Jelte-Boumans/balancerende-robot/GIP Presentatie.pptx

## Balancerende Robot

Jelte Boumans
6EA-ICT
1

## Blokschema

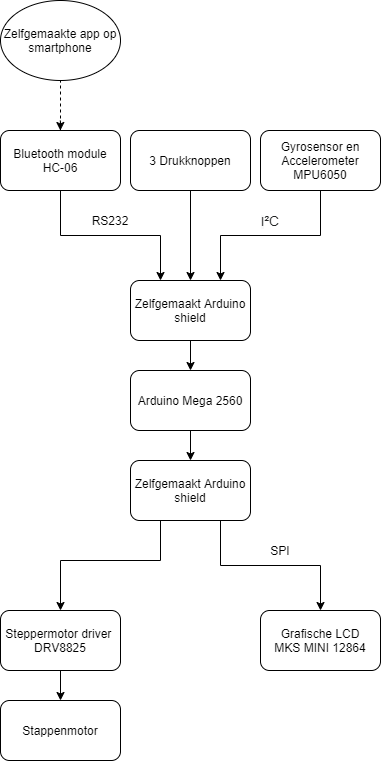
[picture p36: figure]

## Schema

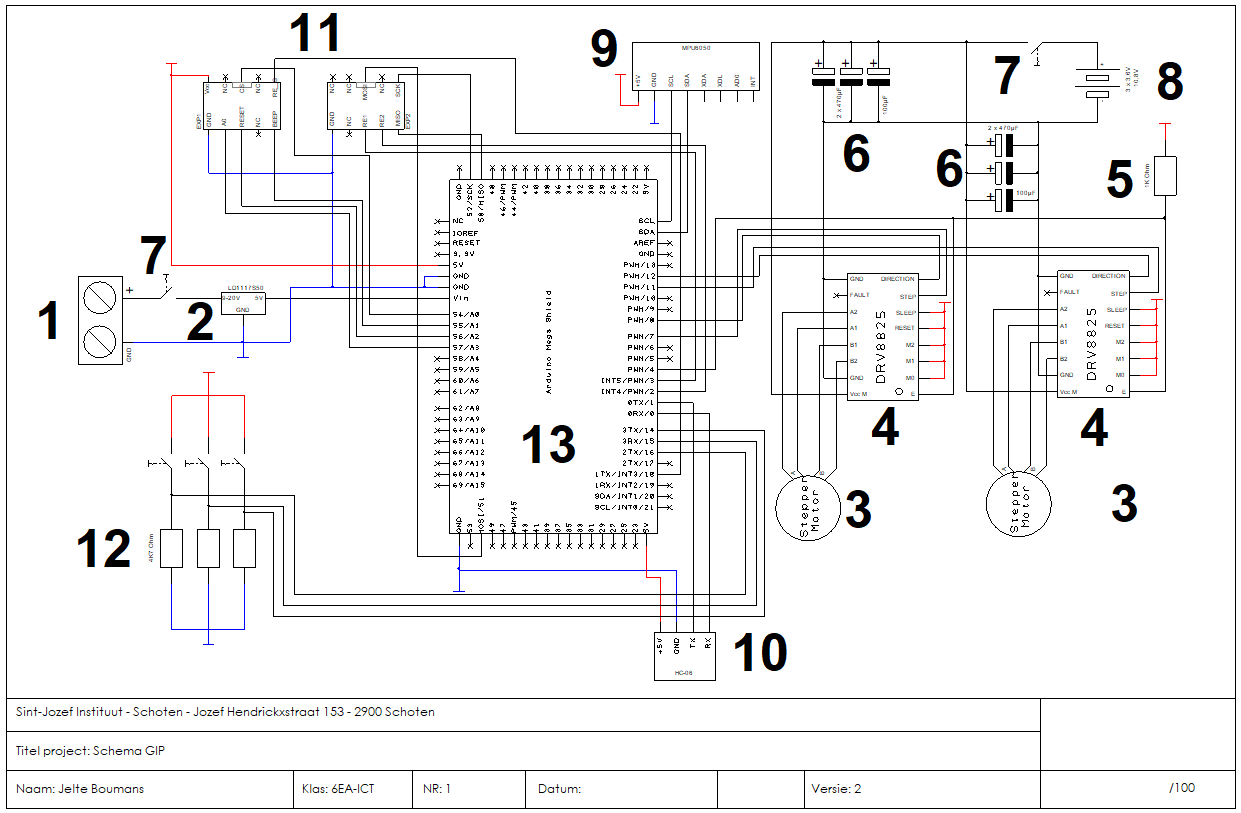
[picture p37: figure]

## DRV8825

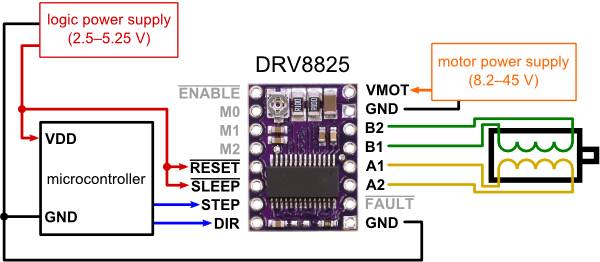
[picture p38: figure]

## MPU6050

- Accelerometer
- Gyro sensor
- Corioliskracht

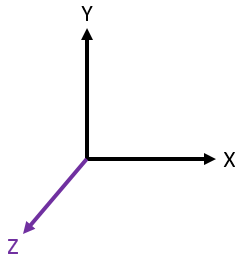
[picture p39: figure]
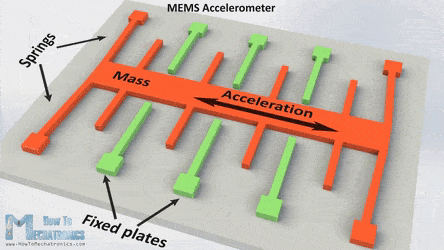
[picture p40: figure]
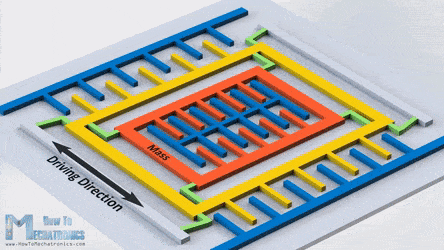
[picture p41: figure]

## Pid

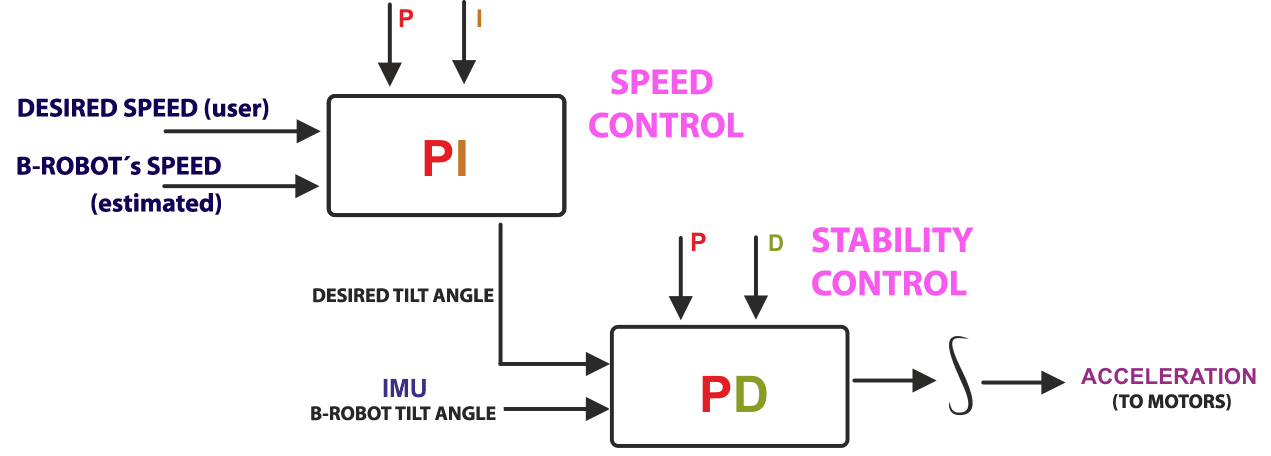
[picture p42: figure]
BROBOT_control1

## Problemen

- Onstabiele software
- Voeding
- GLCD

## Extra’s

- Lijnvolger
- Gradenmeter op app
- Rechtkomen

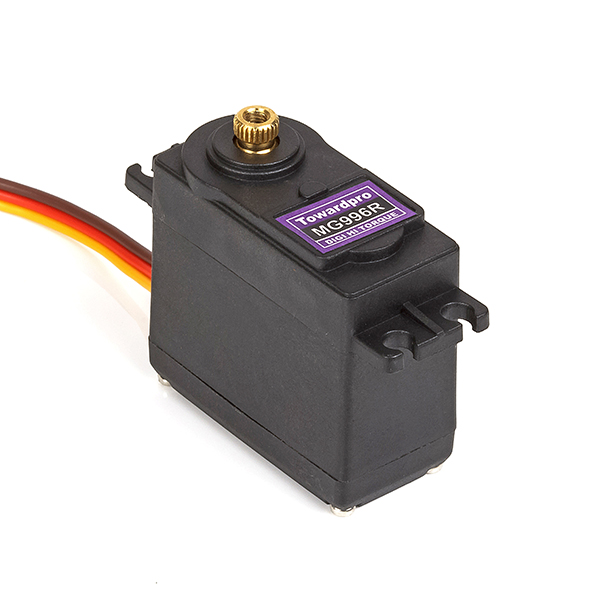
[picture p43: figure]
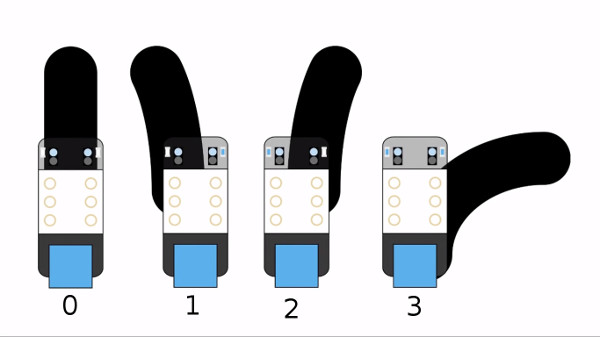
[picture p44: figure]

## App

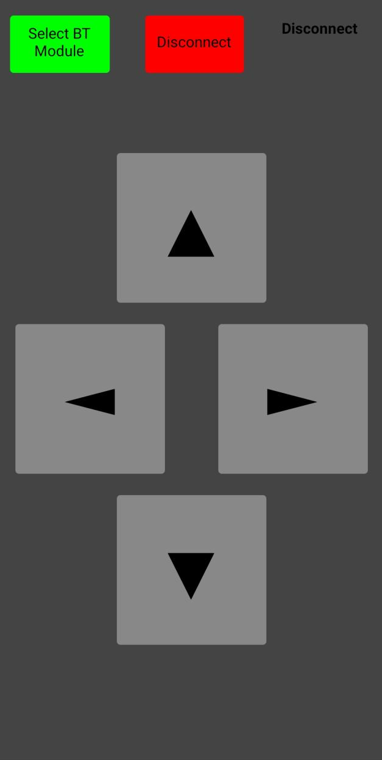
[picture p45: figure]

## einde
