Jelte-Boumans/balancerende-robot/Onderzoeksvragen/DRV2588/DRV8825_Pinlayout.png

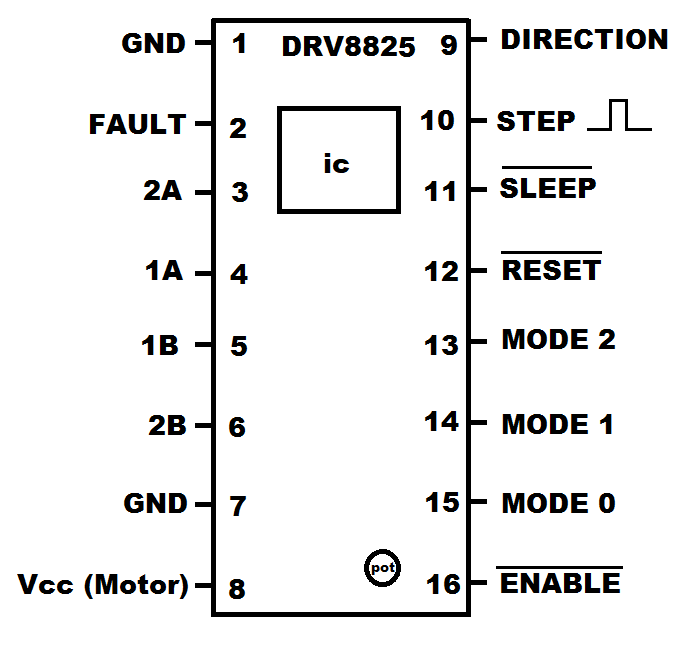
Onderzoeksvragen/DRV2588/DRV8825_Pinlayout.png
