Jelte-Boumans/balancerende-robot/Stukkenlijst.xlsx

Componenten: | Farnell nummer: | Aantal: | Prijs: | Totaalprijs:
Arduino Mega 2560 | Banggood (https://www.banggood.com/Geekcreit-MEGA-2560-R3-ATmega2560-MEGA2560-Development-Board-With-USB-Cable-p-73020.html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) | 1 | 12.09 € | 12.09 €
HC-06 | Banggood (https://nl.banggood.com/HC-06-Wireless-Bluetooth-Transceiver-RF-Main-Module-Serial-For-Arduino-p-80364.html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) | 1 | 2.70 € | 2.70 €
GY-521/MPU-6050 | HobbyElectronica (https://www.hobbyelectronica.nl/product/mpu-6050/) | 1 | 3.95 € | 3.95 €
DRV8825 | Pololu (https://www.pololu.com/product/2133) | 2 | 8.95 € | 17.90 €
Stappenmotor | 2507563 | 2 | 26.38 € | 52.76 €
9V batterij | 2503729 | 1 | 3.00 € | 3.00 €
9V batterij connector | 2646477 | 1 | 1.24 € | 1.24 €
3,6V batterij (18650) | Conrad (https://www.conrad.be/p/samsung-inr18650-30q-speciale-oplaadbare-batterij-18650-flat-top-geschikt-voor-hoge-stroomsterktes-li-ion-36-v-3000-ma-1558875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) | 3 | 7.70 € | 23.10 €
3,6V batterij houder | Banggood (https://nl.banggood.com/3pcs-4-Slots-18650-Battery-Holder-Plastic-Case-Storage-Box-for-43_7V-18650-Lithium-Battery-p-1475615.html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) | 3 | 2.78 € | 8.34 €
Condensator 470µF | 1144616 | 4 | 0.26 € | 1.04 €
Condensator 100µF | 8767122 | 2 | 0.15 € | 0.30 €
Weerstand 1KΩ | 2614353 | 1 | 0.15 € | 0.15 €
Male pin headers | 9729038 | 1 | 1.67 € | 1.67 €
Female pin headers | 1593472 | 1 | 0.50 € | 0.50 €
Schakelaar | 7674180 | 2 | 3.66 € | 7.32 €
 |  |  | Totaalprijs van alles → | 136.06 €
