Jelte-Boumans/balancerende-robot/Lasercut Files/Level2 (Arduino).dxf

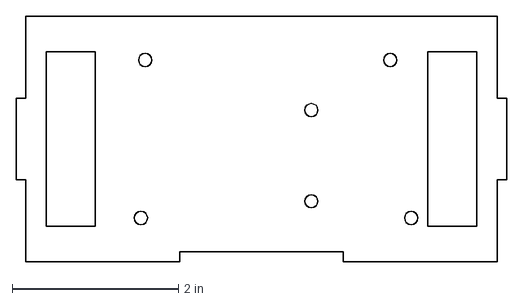
[picture p174: CAD file, 2023-07-24]
Lasercut Files/Level2 (Arduino).dxf
5.91 x 2.95 in
