Jelte-Boumans/balancerende-robot/Lasercut Files/Level1 (Motoren).dxf

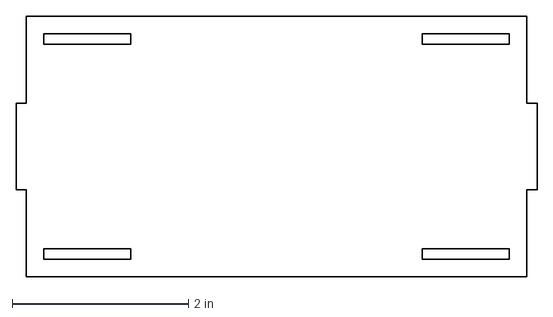
[picture p175: CAD file, 2023-07-24]
Lasercut Files/Level1 (Motoren).dxf
5.91 x 2.95 in
