Jelte-Boumans/balancerende-robot/Lasercut Files/Support Piece.dxf

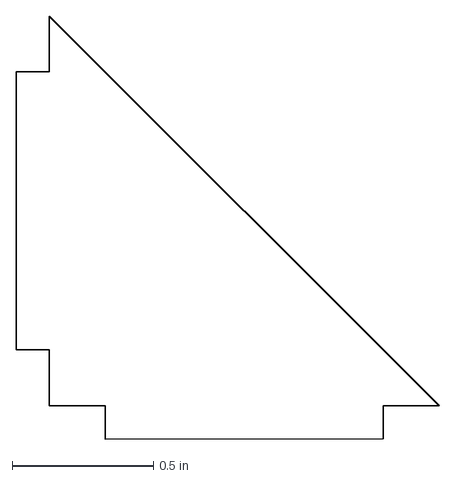
[picture p176: CAD file, 2023-07-24]
Lasercut Files/Support Piece.dxf
1.50 x 1.50 in
