Jelte-Boumans/balancerende-robot/Lasercut Files/Level4 (Sensor + Schakelaars).dxf

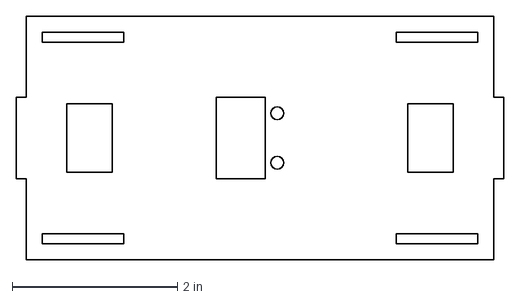
[picture p177: CAD file, 2023-07-24]
Lasercut Files/Level4 (Sensor + Schakelaars).dxf
5.91 x 2.95 in
