Jelte-Boumans/balancerende-robot/Lasercut Files/Level2-3 (GLCD).dxf

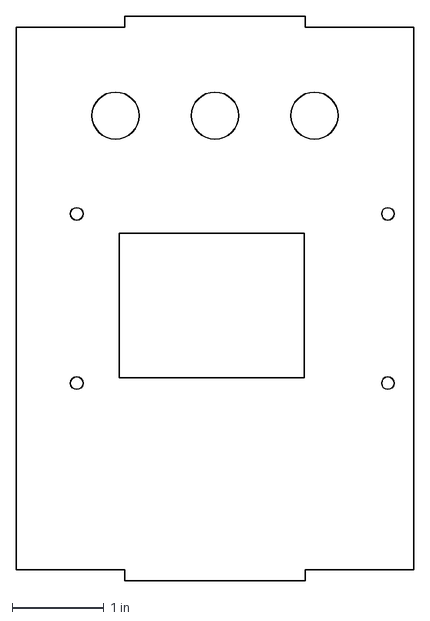
[picture p178: CAD file, 2023-07-24]
Lasercut Files/Level2-3 (GLCD).dxf
4.33 x 6.14 in
