Jelte-Boumans/balancerende-robot/Lasercut Files/Muur.dxf

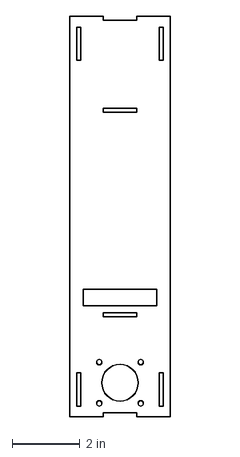
[picture p179: CAD file, 2023-07-24]
Lasercut Files/Muur.dxf
2.95 x 11.8 in
