Jelte-Boumans/balancerende-robot/Lasercut Files/Level3 (Voeding).dxf

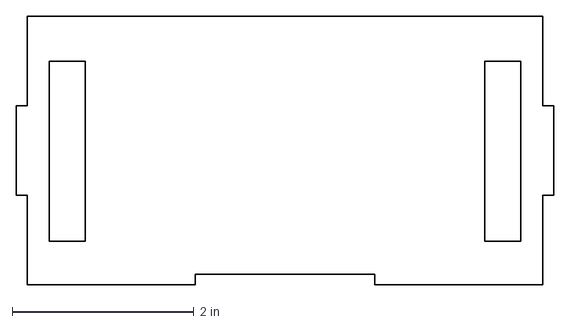
[picture p180: CAD file, 2023-07-24]
Lasercut Files/Level3 (Voeding).dxf
5.91 x 2.95 in
