Jelte-Boumans/balancerende-robot/(list of files, cad)

Other CAD files:
3D Tekeningen/Versie 1/Level1 (motoren).ipt
3D Tekeningen/Versie 1/Level2 (arduino).ipt
3D Tekeningen/Versie 1/Level3 (voeding).ipt
3D Tekeningen/Versie 1/Level4 (sensor + schakelaar).ipt
3D Tekeningen/Versie 1/MuurL.ipt
3D Tekeningen/Versie 1/MuurR.ipt
3D Tekeningen/Versie 1/OldVersions/Level4 (sensor + schakelaar).0007.ipt
3D Tekeningen/Versie 1/OldVersions/MuurL.0005.ipt
3D Tekeningen/Versie 1/OldVersions/Robot.0005.iam
3D Tekeningen/Versie 1/Robot.iam
3D Tekeningen/Versie 2/Level1 (Motoren).ipt
3D Tekeningen/Versie 2/Level2 (Arduino).ipt
3D Tekeningen/Versie 2/Level2-3 (GLCD).ipt
3D Tekeningen/Versie 2/Level3 (Voeding).ipt
3D Tekeningen/Versie 2/Level4 (Sensor + Schakelaars).ipt
3D Tekeningen/Versie 2/Muur.ipt
3D Tekeningen/Versie 2/OldVersions/Level2-3 (GLCD).0008.ipt
3D Tekeningen/Versie 2/Robot.iam
3D Tekeningen/Versie 2/Support Piece.ipt
3D Tekeningen/Versie 2/Wiel.ipt
3D Tekeningen/Versie 3/Level1 (Motoren).ipt
3D Tekeningen/Versie 3/Level2 (Arduino).ipt
3D Tekeningen/Versie 3/Level2-3 (GLCD).ipt
3D Tekeningen/Versie 3/Level3 (Voeding).ipt
3D Tekeningen/Versie 3/Level4 (Sensor + Schakelaars).ipt
3D Tekeningen/Versie 3/Muur.ipt
