Jelte-Boumans/balancerende-robot/(list of files, drawings)

Other design files:
Schema's/Shield/Versie 1/GIP Shield 1.pcb
Schema's/Shield/Versie 1/~GIP Shield 1.pcb
Schema's/Shield/Versie 2/GIP Shield 2.pcb
Schema's/Shield/Versie 2/~GIP Shield 2.pcb
